Wladymyr1996/Vypaluvach/README.md

# Vypaluvach
"Vypaluvach" this is my project of CNC image woodburner
