Wladymyr1996/Vypaluvach/Desktop/README.md

# Vypaluvach
This program make for a CNC wood burner.
    "Vypaluvach" - is control program for CNC wood burner "CNC Vypaluvach" 
    Copyright (C) 2017 Volodymyr Stadnyk
    e-mail: Wladymyr1996@gmail.com

    This program is free software: you can redistribute it and/or modify
    it under the terms of the GNU General Public License as published by
    the Free Software Foundation, either version 3 of the License, or
    (at your option) any later version.

    This program is distributed in the hope that it will be useful,
    but WITHOUT ANY WARRANTY; without even the implied warranty of
    MERCHANTABILITY or FITNESS FOR A PARTICULAR PURPOSE.  See the
    GNU General Public License for more details.

    You should have received a copy of the GNU General Public License
    along with this program.  If not, see <https://www.gnu.org/licenses/>

// PREINSTALL // (uk)ГОТУВАННЯ ДО ВСТАНОВЛЕННЯ // (ru)ПОДГОТОВКА К УСТАНОВКЕ //

Befor install you need install package: qt5-default qtbase5-examples qtdeclarative5-examples libqt5serialport5-dev g++
(uk) Перед встановленням необхідно встановити пакети: qt5-default qtbase5-examples qtdeclarative5-examples libqt5serialport5-dev g++
(ru) Перед установкой необходимо установить пакеты: qt5-default qtbase5-examples qtdeclarative5-examples libqt5serialport5-dev g++

// INSTALATION // (uk)ВСТАНОВЛЕННЯ // (ru)УСТАНОВКА //

For installation you can run the script "install sh" as root, for example "sudo sh install.sh"
(uk)Для встановлення, Ви можете запустити скрипт "install.sh" як root, наприклад "sudo sh install.sh"
(ru)Для установки, Вы можете запустить скрипт "install.sh" как root, например "sudo sh install.sh"

// DEINSTALLATION // (uk)ВИДАЛДЕННЯ // (ru)УДАЛЕНИЕ //

For uninstall you can run the script "uninstall.sh" as root, for example "sudo sh uninstall.sh" or "sudo sh /opt/Volodya/Vypaluvach/uninstall.sh"
(uk)Для видалення Ви можете запустити скрипт "uninstall.sh" як root, наприклад "sudo sh uninstall.sh" або "sudo sh /opt/Volodya/Vypaluvach/uninstall.sh"
(ru)Для удаления Вы можете запустить скрипт "uninstall.sh" как root, например  "sudo sh uninstall.sh" или "sudo sh /opt/Volodya/Vypaluvach/uninstall.sh"
