Wladymyr1996/Vypaluvach/KiCAD Project/vypaluvach_board.pdf

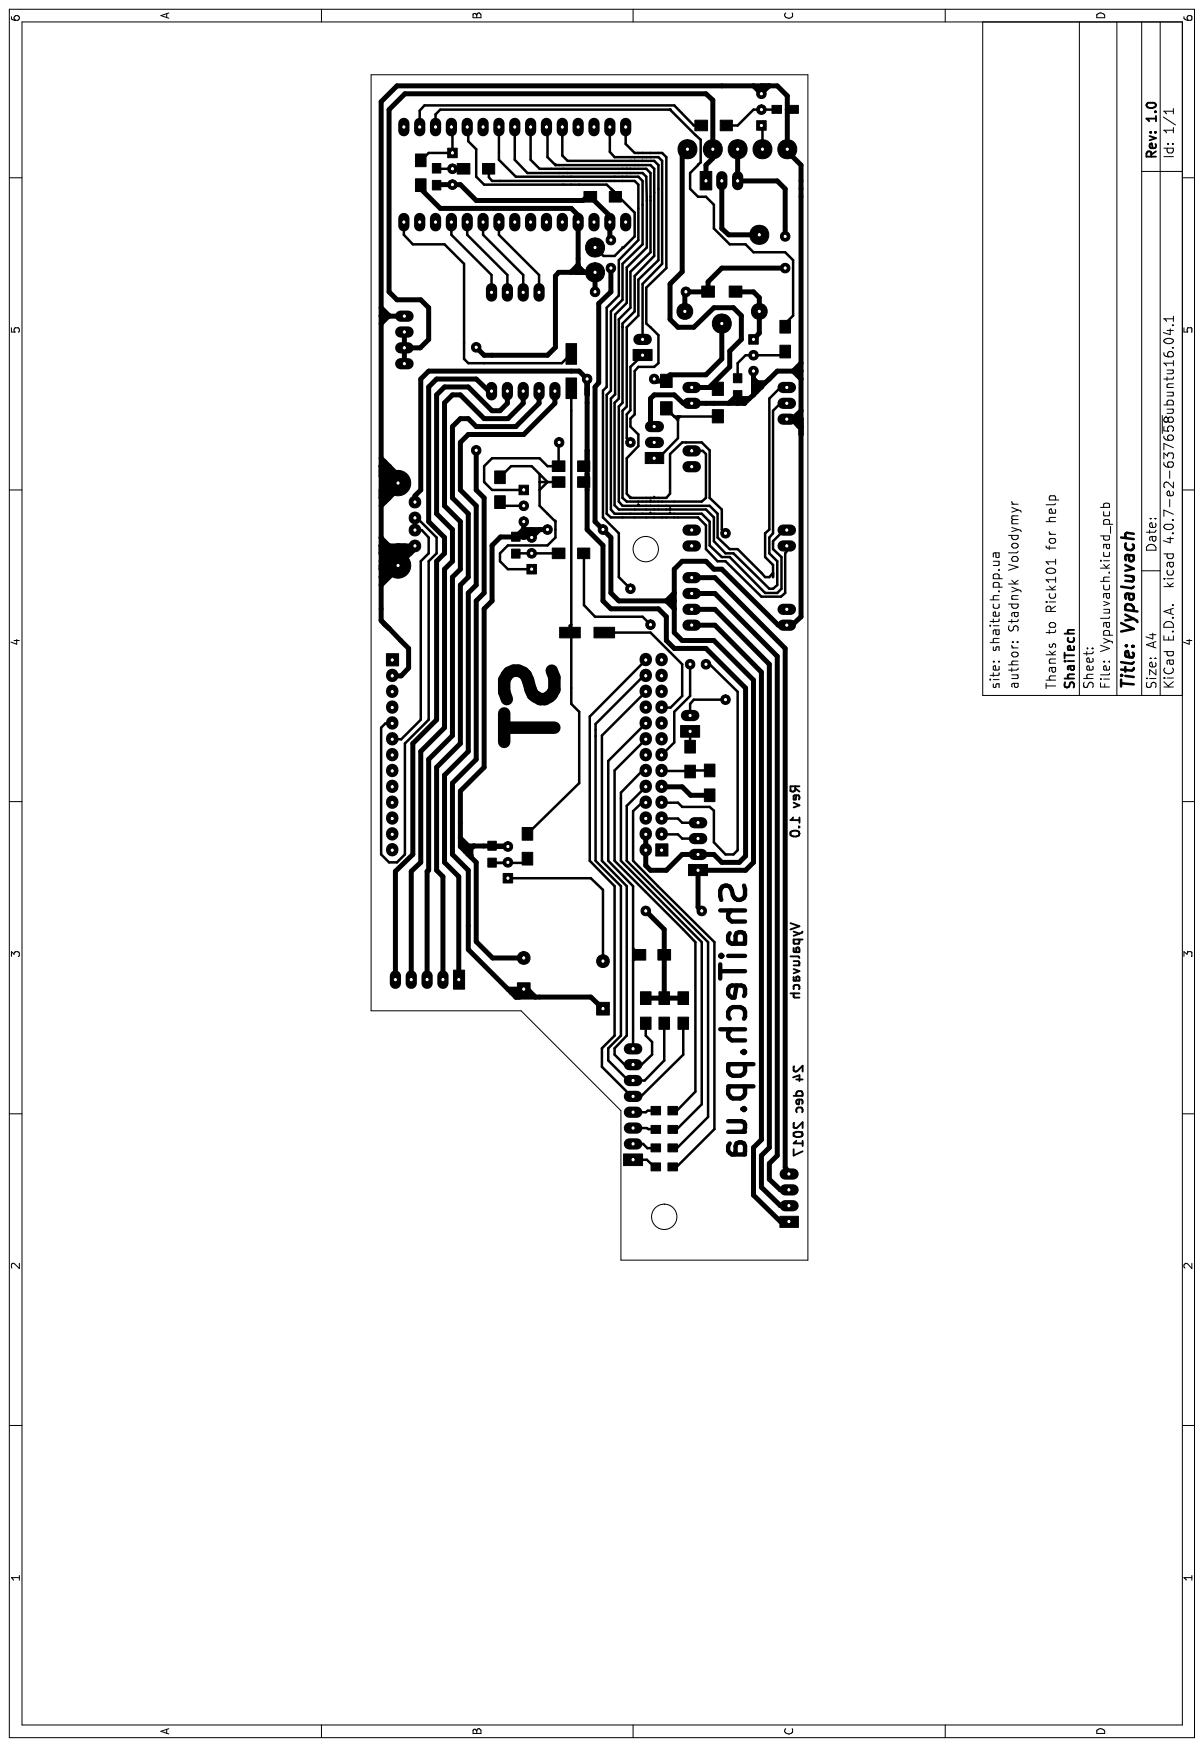
[picture p1: page 1]
