Wladymyr1996/Vypaluvach/KiCAD Project/Vypaluvach.kicad_pcb

## KiCad design KiCAD Project/Vypaluvach.kicad_pcb (2018-01-21)

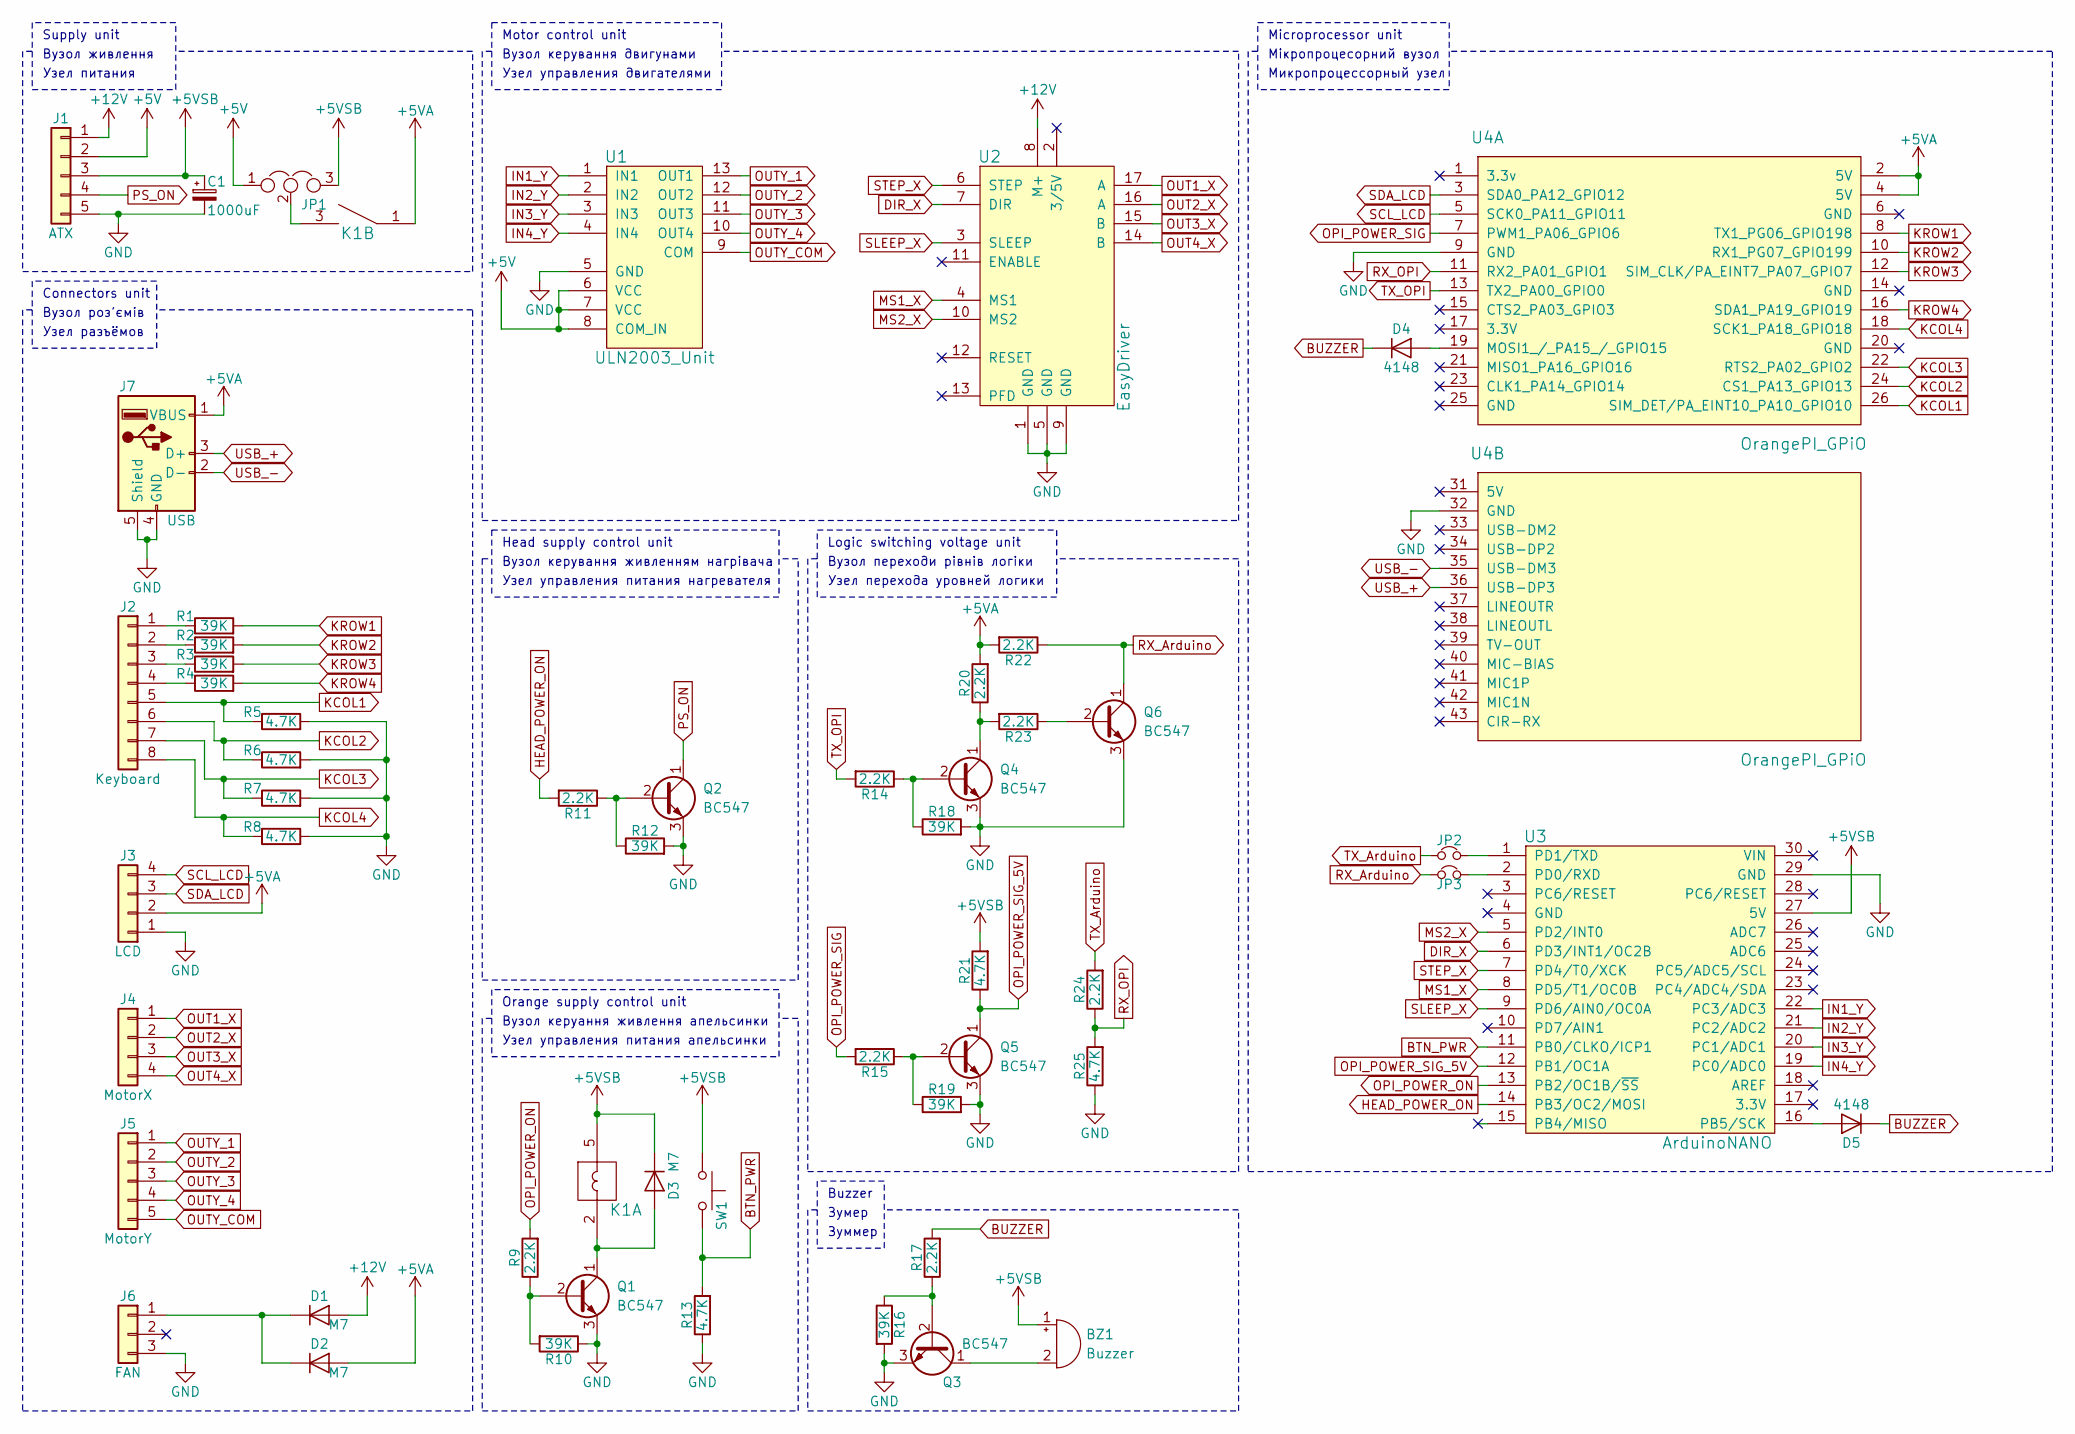
[picture p2: schematic Vypaluvach.sch]

Parts:
BZ1: Buzzer; Buzzer_12x9.5RM7.6
C1: 1000uF; CP_Radial_D10.0mm_P5.00mm
D1, D2, D3: M7; DO-214AC
D4, D5: 4148; D_MiniMELF_Handsoldering
J1: ATX; Conn_1x5_d1.5mm
J2: Keyboard; Conn_1x8_d1mm
J3: LCD; Conn_1x4_d1mm
J4: MotorX; Conn_1x4_d1mm
J5: MotorY; Conn_1x5_d1mm
J6: FAN; Conn_1x3_d1mm
J7: USB
JP1: OPIPowerSel; Conn_1x3_d1mm
JP2, JP3: Jumper_NC_Small; Conn_1x2_d1mm
K1: SimpleReley; Relay_SPST_SANYOU_SRD_Series_Form_A
Q1, Q2, Q3, Q4, Q5, Q6: BC547; TO-92_Inline_Wide
R1, R2, R3, R4, R10, R12, R16, R18, R19: 39K; R_0805_HandSoldering
R5, R6, R7, R8, R13, R21, R25: 4.7K; R_1206_HandSoldering
R9, R11, R14, R15, R17, R20, R22, R23, R24: 2.2K; R_1206_HandSoldering
SW1: SW_Push; Conn_1x2_d1.5mm
U1: ULN2003_Unit; ULN2003APG_driver
U2: EasyDriver
U3: ArduinoNANO
U4: OrangePI_GPiO; OrangePi_Zero

Connections:
+5V: J1.2, JP1.1, U1.6 (VCC), U1.7 (VCC), U1.8 (COM_IN)
+5VA: D2.2 (A), J3.2, J7.1 (VBUS), K1.1, R20.2, R22.2, U4.2 (5V), U4.4 (5V)
+5VSB: BZ1.1 (-), C1.1, D3.1 (K), J1.3, JP1.3, K1.5, R21.2, SW1.1, U3.27 (5V)
+12V: D1.2 (A), J1.1, U2.8 (M+)
BTN_PWR: R13.2, SW1.2, U3.11 (PB0/CLKO/ICP1)
BUZZER: D4.1 (K), D5.1 (K), R17.2
DIR_X: U2.7 (DIR), U3.6 (PD3/INT1/OC2B)
GND: C1.2, J1.5, J3.1, J6.3, J7.4 (GND), J7.5 (Shield), Q1.3 (E), Q2.3 (E), Q3.3 (E), Q4.3 (E), Q5.3 (E), Q6.3 (E), R5.2, R6.2, R7.2, R8.2, R10.1, R12.2, R13.1, R16.2, R18.2, R19.2, R25.1, U1.5 (GND), U2.1 (GND), U2.5 (GND), U2.9 (GND), U3.29 (GND), U4.9 (GND), U4.32 (GND)
HEAD_POWER_ON: R11.2, U3.14 (PB3/OC2/MOSI)
IN1_Y: U1.1 (IN1), U3.22 (PC3/ADC3)
IN2_Y: U1.2 (IN2), U3.21 (PC2/ADC2)
IN3_Y: U1.3 (IN3), U3.20 (PC1/ADC1)
IN4_Y: U1.4 (IN4), U3.19 (PC0/ADC0)
KCOL1: J2.5, R5.1, U4.26 (SIM_DET/PA_EINT10_PA10_GPIO10)
KCOL2: J2.6, R6.1, U4.24 (CS1_PA13_GPIO13)
KCOL3: J2.7, R7.1, U4.22 (RTS2_PA02_GPIO2)
KCOL4: J2.8, R8.1, U4.18 (SCK1_PA18_GPIO18)
KROW1: R1.2, U4.8 (TX1_PG06_GPIO198)
KROW2: R2.2, U4.10 (RX1_PG07_GPIO199)
KROW3: R3.2, U4.12 (SIM_CLK/PA_EINT7_PA07_GPIO7)
KROW4: R4.2, U4.16 (SDA1_PA19_GPIO19)
MS1_X: U2.4 (MS1), U3.8 (PD5/T1/OC0B)
MS2_X: U2.10 (MS2), U3.5 (PD2/INT0)
unnamed: BZ1.2 (+), Q3.1 (C)
unnamed: D1.1 (K), D2.1 (K), J6.1
unnamed: D3.2 (A), K1.2, Q1.1 (C)
unnamed: D4.2 (A), U4.19 (MOSI1_/_PA15_/_GPIO15)
unnamed: D5.2 (A), U3.16 (PB5/SCK)
unnamed: J2.1, R1.1
unnamed: J2.2, R2.1
unnamed: J2.3, R3.1
unnamed: J2.4, R4.1
unnamed: JP1.2, K1.3
unnamed: JP2.2, U3.1 (PD1/TXD)
unnamed: JP3.2, U3.2 (PD0/RXD)
unnamed: Q1.2 (B), R9.1, R10.2
unnamed: Q2.2 (B), R11.1, R12.1
unnamed: Q3.2 (B), R16.1, R17.1
unnamed: Q4.1 (C), R20.1, R23.2
unnamed: Q4.2 (B), R14.1, R18.1
unnamed: Q5.2 (B), R15.1, R19.1
unnamed: Q6.2 (B), R23.1
OPI_POWER_ON: R9.2, U3.13 (PB2/OC1B/~SS)
OPI_POWER_SIG: R15.2, U4.7 (PWM1_PA06_GPIO6)
OPI_POWER_SIG_5V: Q5.1 (C), R21.1, U3.12 (PB1/OC1A)
OUT1_X: J4.1, U2.17 (A)
OUT2_X: J4.2, U2.16 (A)
OUT3_X: J4.3, U2.15 (B)
OUT4_X: J4.4, U2.14 (B)
OUTY_1: J5.1, U1.13 (OUT1)
OUTY_2: J5.2, U1.12 (OUT2)
OUTY_3: J5.3, U1.11 (OUT3)
OUTY_4: J5.4, U1.10 (OUT4)
OUTY_COM: J5.5, U1.9 (COM)
PS_ON: J1.4, Q2.1 (C)
RX_Arduino: JP3.1, Q6.1 (C), R22.1
RX_OPI: R24.1, R25.2, U4.11 (RX2_PA01_GPIO1)
SCL_LCD: J3.4, U4.5 (SCK0_PA11_GPIO11)
SDA_LCD: J3.3, U4.3 (SDA0_PA12_GPIO12)
SLEEP_X: U2.3 (SLEEP), U3.9 (PD6/AIN0/OC0A)
STEP_X: U2.6 (STEP), U3.7 (PD4/T0/XCK)
TX_Arduino: JP2.1, R24.2
TX_OPI: R14.2, U4.13 (TX2_PA00_GPIO0)
USB_+: J7.3 (D+), U4.36 (USB-DP3)
USB_-: J7.2 (D-), U4.35 (USB-DM3)

Notes on the sheet:
Вузол живлення
Supply unit
Узел питания
Motor control unit
Вузол керування двигунами
Узел управления двигателями
Microprocessor unit
Мікропроцесорний вузол
Микропроцессорный узел
Logic switching voltage unit
Вузол переходи рівнів логіки
Узел перехода уровней логики
Buzzer
Зумер
Зуммер
Orange supply control unit
Вузол керуання живлення апельсинки
Узел управления питания апельсинки
Connectors unit
Вузол роз'ємів
Узел разъёмов
Head supply control unit
Вузол керування живленням нагрівача
Узел управления питания нагревателя

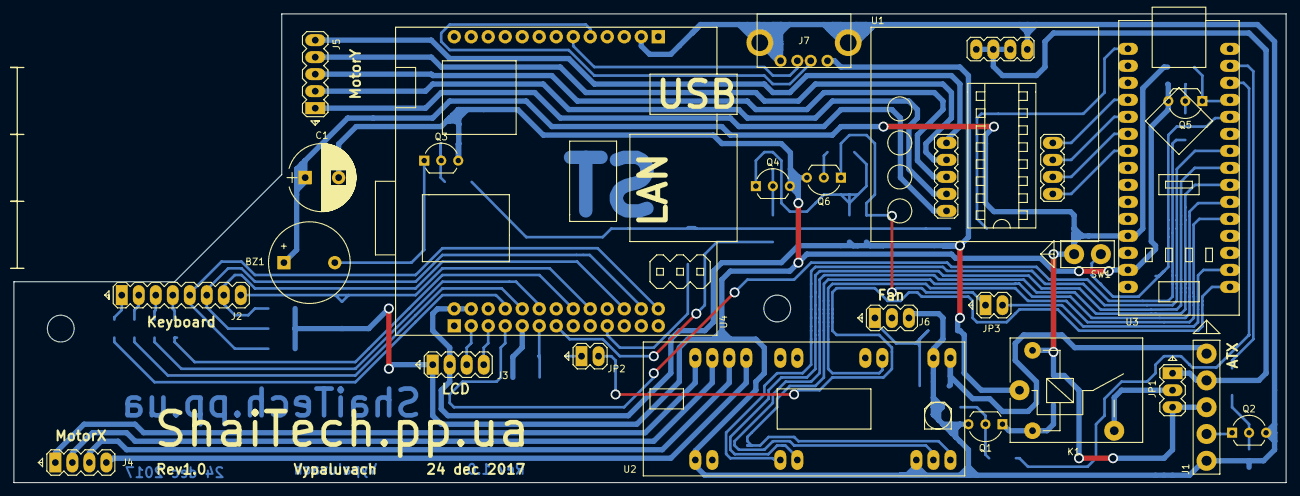
[picture p3: board Vypaluvach.kicad_pcb from above]

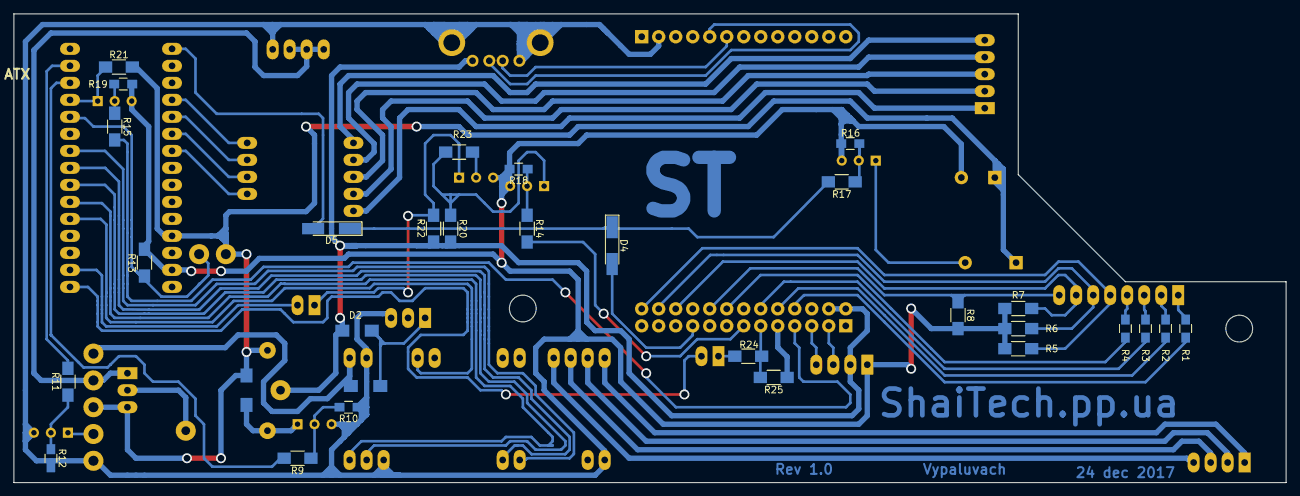
[picture p4: board Vypaluvach.kicad_pcb from below]

Board: 2 copper layers, 190.0 x 70.0 mm, 54 parts (30 on the bottom side), 65 nets.
