Wladymyr1996/Vypaluvach/(commit log)

2018-01-21 Rev 1
    [Vypaluvach.kicad_pcb, Vypaluvach.sch]
2018-01-26 Adding board PDF
