Wladymyr1996/Vypaluvach/(notices)

Notices in the files:
Server/gpio/gpio_lib.h:
pyA20 is free software; you can redistribute it and/or modify
the Free Software Foundation; either version 2 of the License, or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
